mr-rooney/moitessier-hw/README.md

Hardware Design
===============

Hardware related files (gerber, schematic, etc.) of the Moitessier HAT.
