mr-rooney/moitessier-hw/PE770010E05-X1/silkscreen_bottom.png

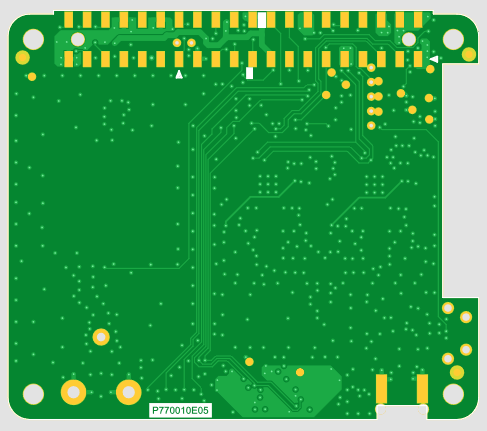
PE770010E05-X1/silkscreen_bottom.png
