mr-rooney/moitessier-hw/PE770010E05-X1/silkscreen_top.png

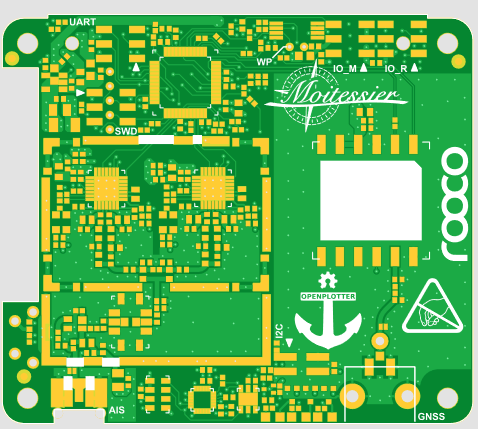
PE770010E05-X1/silkscreen_top.png
