mr-rooney/moitessier-hw/PE770010E05-X1/PE770010E05-X1-BM_v0.1.xlsx

Sheet: BOM complete
Project | Moitessier HAT
Hardware ID | P770010
Hardware Version | E05
Variant | X1
PCB Size (LxB) [mm] | 65 x 56,5
Min. Temperature Range [°C] | -20
Max. Temperature Range [°C] | 55
Manufacturer Part Number | Manufacturer | Description | Package/Case | Temperature Range [°C] |  | Reference | Quantity
GRM155R60J475ME87D | Murata | ceramic chip capacitor, 4.7uF, 6.3V, X5R, 0402 | 0402 | -55°C | 85°C | C200, C224, C606 | 3
GCM155R71C104KA55D | Murata | ceramic chip capacitor, 100n, 50V, X7R, 0402 | 0402 | -55°C | 125°C | C201, C211, C212, C213, C223, C225, C235, C236, C237, C242, C401, C402, C500, C501, C504, C601, C602, C603, C604, C605, C701, C702, C703, C704, C705, C706, C709, C711 | 28
CL10A106KP8NNNC | Samsung | ceramic chip capacitor, 10uF, 16V, X5R, 0603 | 0603 | -55°C | 85°C | C202, C226, C403, C707 | 4
C0402C120J5GACTU | Kemet | ceramic chip capacitor, 12p, 50V, C0G, 0402 | 0402 | -55°C | 125°C | C203, C208, C227, C232 | 4
CC0402DRNPO9BN100 | Yageo | ceramic chip capacitor, 10pF, 50V, NP0, 0402 | 0402 | -55°C | 125°C | C204, C206, C209, C214, C228, C230, C233, C238 | 8
C0402C102J5GACTU | Kemet | ceramic chip capacitor, 1nF, 50V, NP0, 0402 | 0402 | -55°C | 125°C | C205, C216, C217, C221, C222, C229, C241, C243, C300, C302, C303 | 11
GJM1555C1H140GB01D | Murata | ceramic chip capacitor, 14pF, 25V, NP0, 0402 | 0402 | -55°C | 125°C | C207, C218, C219, C231 | 4
885012005013 | Würth | ceramic chip capacitor, 100pF, 50V, C0G, 0402 | 0402 | -55°C | 125°C | C210, C234, C301 | 3
C0402C390J5GACTU | Kemet | ceramic chip capacitor, 39pF, 50V, NP0, 0402 | 0402 | -55°C | 125°C | C215, C239 | 2
GCM155R71H103KA55D | Murata | ceramic chip capacitor, 10nF, 50V, X7R, 0402 | 0402 | -55°C | 125°C | C220, C240, C700, C708, C710 | 5
GRM31CR60J107KE39L | Murata | ceramic chip capacitor, 100u, 6.3V, X5R, 1206 | 1206 | -55°C | 85°C | C502 | 1
CL21A106KQCLRNC | Samsung | ceramic chip capacitor, 10u, 16V, X5R, 0805 | 0805 | -55°C | 85°C | C503 | 1
885012205048 | Würth | ceramic chip capacitor, 4.7nF, 50V, X7R, 0402 | 0402 | -55°C | 125°C | C600 | 1
PESD18VF1BL | NXP | ultra low capacitance bidrectional ESD protection diode | SOD-882 | -55°C | 150°C | D300, D400 | 2
LTST-S270KGKT | Lite-On | LED, green, 45mcd |  | -30°C | 80°C | D700, D702 | 2
LTST-S270KRKT | Lite-On | LED, red, 54mcd |  | -30°C | 80°C | D701 | 1
5414373-1 | TE | BNC female jack, DC -4 GHz |  | -55°C | 85°C | J501 | 1
CRCW040212K0FKED | Vishay | thick film resistor, 12k, 1%, 100ppm, 0402, 63mW | 0402 | -55°C | 155°C | R201, R205, R601, R708, R714, R716 | 6
CRCW040251K0FKED | Panasonic | thick film resistor, 51k, 1%, 100ppm, 0402 | 0402 | -55°C | 155°C | R713 | 1
ERJ-2RKF1000X | Panasonic | thick film resistor, 100R, 1%, 100ppm, 0402 | 0402 | -55°C | 155°C | R202, R705, R706, R707, R717 | 5
RC0402FR-131KL | Yageo | thick film resistor, 1k, 1%, 100ppm, 0402 | 0402 | -55°C | 155°C | R204, R207, R504, R608, R710 | 5
CRCW08050000Z0EB | Vishay | thick film resistor, 0R, 1%, 100ppm, 0805 | 0805 | -55°C | 155°C | R300 | 1
RC0402FR-070RL | Yageo | thick film resistor, 0R, 1%, 100ppm, 0402 | 0402 | -55°C | 155°C | R302, R303, R304, R404, R606, R607 | 6
CRCW0402240RFKEDC | Vishay | thick film resistor, 240R, 1%, 100ppm, 0402 | 0402 | -55°C | 155°C | R402 | 1
CRCW04023K30FKEDC | Vishay | thick film resistor, 3.3k, 1%, 100ppm, 0402 | 0402 | -55°C | 155°C | R501, R502, R503, R600, R603, R605, R700, R715 | 8
CRCW0402100KJNEDC | Vishay | thick film resistor, 100k, 1%, 100ppm, 0402 | 0402 | -55°C | 155°C | R602 | 1
CRCW040233R0FKEDC | Vishay | thick film resistor, 33R, 1% , 100ppm, 0402 | 0402 | -55°C | 155°C | R701, R702, R703, R704 | 4
SSM3J36FS,LF | Toshiba | PMOS, -20V, -760mA | SOT-416 | -55°C | 150°C | T600 | 1
NX138BKW | NEXPERIA | N-Channel Trench MOSFET, 60V, 210 mA | SC-70-3 | -55°C | 150°C | T700, T701, T702 | 3
L86-M33 | Quectel | GPS/GNSS antenna module supporting parallel GPS/GLONASS | 18.4x18.4mm | -40°C | 85°C | U400 | 1
CAT24C32YI | Microchip | 32kBit I2C EEPROM | TSSOP-8 | -40°C | 85°C | U500 | 1
MS5607-02BA03 | Measurement Specialties | barometric pressure sensor, 10mBar to 1200mBar | QFN-8 | -40°C | 85°C | U600 | 1
MPU-9250 | InvenSense | 9-axis (gyro + accelerometer + compass) MEMS motion tracking device | QFN-24 | -40°C | 105°C | U602 | 1
STM32F091CBT6 | STMicroelectronics | ARM Cortex-M0 32 Bit MCU, 128 kB Flash, 32 kB RAM, 48 MHz | LQFP-48 | -40°C | 85°C | U700 | 1
TA0395A | Golledge | SAW filter 159.1625 MHz, max. 20 dBm continuous power input level | 7.0x5.0mm | -30°C | 70°C | FL200 | 1
61004021821 | Würth | header, 2.54mm, 20x2 pin, vertical, surface mount |  | -40°C | 105°C | J502 | 1
7427927261 | Würth | EMI suppression ferrite bead, 100mA, 0.6R, Z=600R@100MHz | 0402 | -55°C | 125°C | L200, L209, L210, L219 | 4
744761215A | Würth | ceramic chip inductor, 0603, 150 nH, 280 mA, 0.92 RDC | 0603 | -40°C | 125°C | L201, L207, L211, L217 | 4
744761168C | Würth | ceramic chip inductor, 0603, 68nH, 600mA, 0.35RDC | 0603 | -40°C | 125°C | L202, L203, L206, L212, L213, L216 | 6
744761172GA | Würth | wire wound ceramic inductor, 0603, 72nH, 2%, 400mA, 0.49RDC, Q=35@150MHz | 0603 | -40°C | 125°C | L208, L218 | 2
744761212C | Würth | wire wound ceramic inductor, 0603, 120nH, 300mA, 0.65RDC, Q=30@150MHz | 0603 | -40°C | 125°C | L204, L205, L214, L215 | 4
744761210A | Würth | ceramic chip inductor, 0603, 100 nH, 400 mA, 0.63 RDC | 0603 | -40°C | 125°C | L300 | 1
742792641 | Würth | EMI suppression ferrite bead, 2A, 0.15R, Z=300R@100MHz | 0603 | -55°C | 125°C | L500 | 1
82357050100 | Würth | ESD suppressor, 5VDC, 60Vclamp, 10pF | 0402 | -40°C | 85°C | D706 | 1
431256038736 | Würth | tactile switch, THT, right angle, 6x6mm |  | -40°C | 85°C | SW700 | 1
S0981-46R | Harwin | clips for S02-30200250 |  |  |  | (see note A) | 4
62100621921 | Würth | header, 2mm, 2x3pin, vertical |  | -40°C | 125°C | J701 | 1
ASF143 | ASB | RF amplifier, 22.7dB | SOT-343 | -65°C | 150°C | U300 | 1
AX5043 | AXSEM | advanced high performance ASK and FSK narrow-band transceiver for 27-1050MHz range | QFN-28 | -40°C | 85°C | U200, U201 | 2
DSB221SDN-13.0000-3.3V-0.5-CS-E | DAISHINKU CORP. | TCXO, 13MHz, -40°C - 85°C, clipped sinde, +/- 0.5ppm frequency stability | 2.5x2.0mm | -40°C | 85°C | X200, X201 | 2
SMA-J-P-H-ST-EM1 | Samtec | SMA socket (female), DC - 6 GHz, edge mount |  | -65°C | 125°C | J500 | 1
Parts available on the assembly diagram and specified in the pick and place file, but not assembled:
Manufacturer Part Number | Manufacturer | Description | Package/Case | Temperature Range [°C] |  | Reference | Quantity
S02-30200250 | Harwin | shielding cabinet, 30x20x3, 4x S1721-46R or 4x S0981-46R clips required (depending on footprint)!!! | 30x20x3mm |  |  | SH200 (see note A) (do not order and do not assemble) | 1
Note A:
The HARWIN shield (SH200) requires 4 clips on the PCB. There are no references for the clips and there is no position data in the pick and place file. Therefore it is necessary to add position information for the assembly machine manually.

Sheet: Selection
ja | -40/85
nein | -55/150
 | -40/125
 | -55/155
 | -55/125
 | 0/70
