mr-rooney/moitessier-hw/PE770010E05-X1/PDF/P770010E05-X1-SH-x.pdf

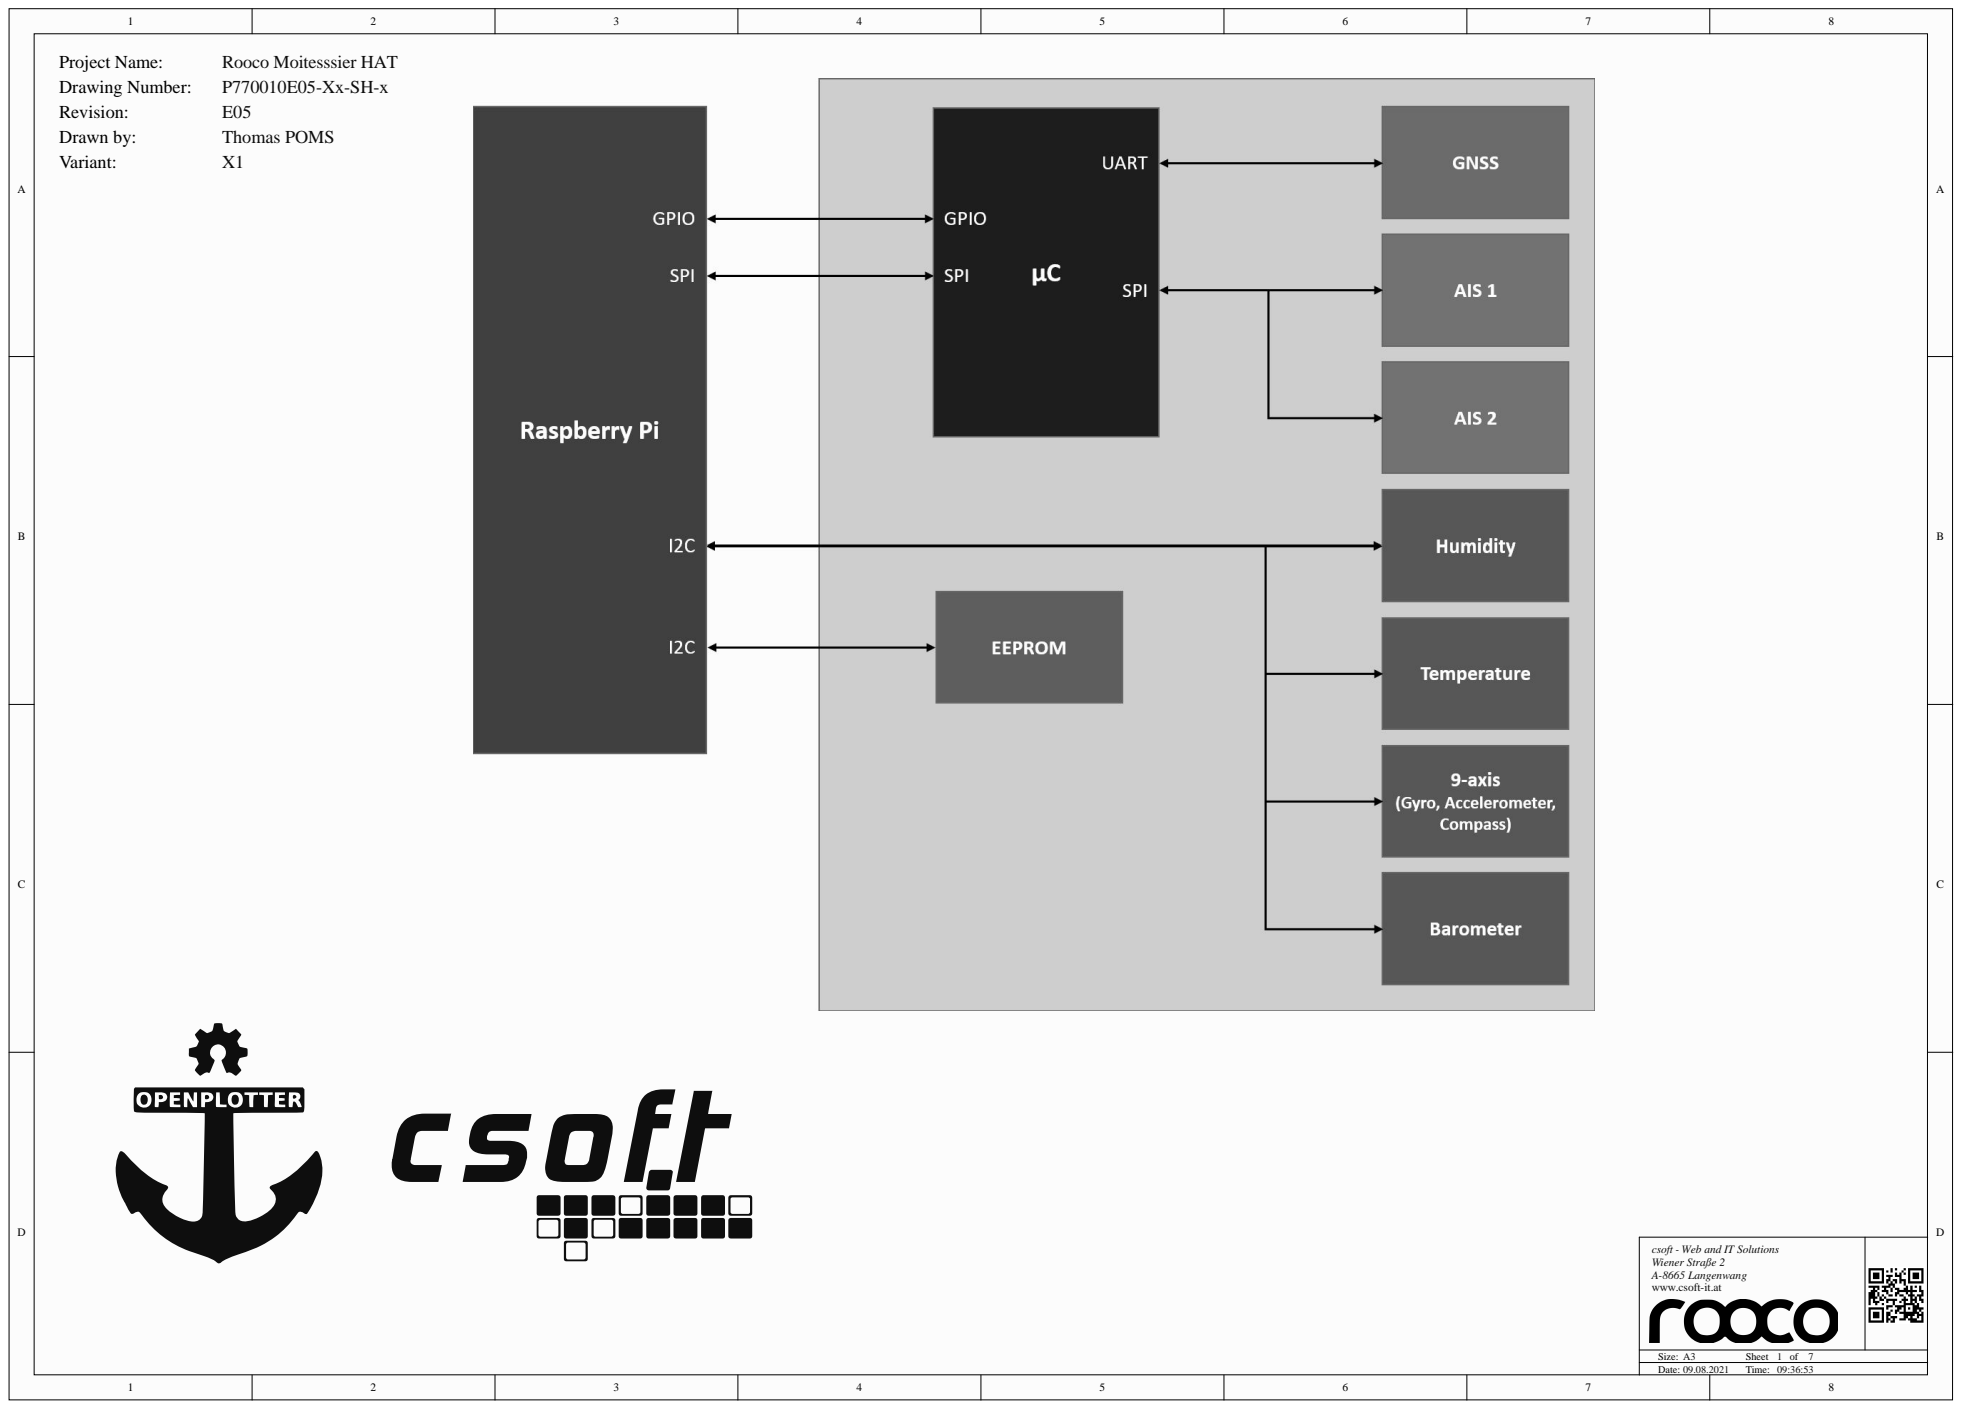
[picture p3: page 1]

csoft - Web and IT Solutions
Wiener Straße 2
A-8665 Langenwang
www.csoft-it.at

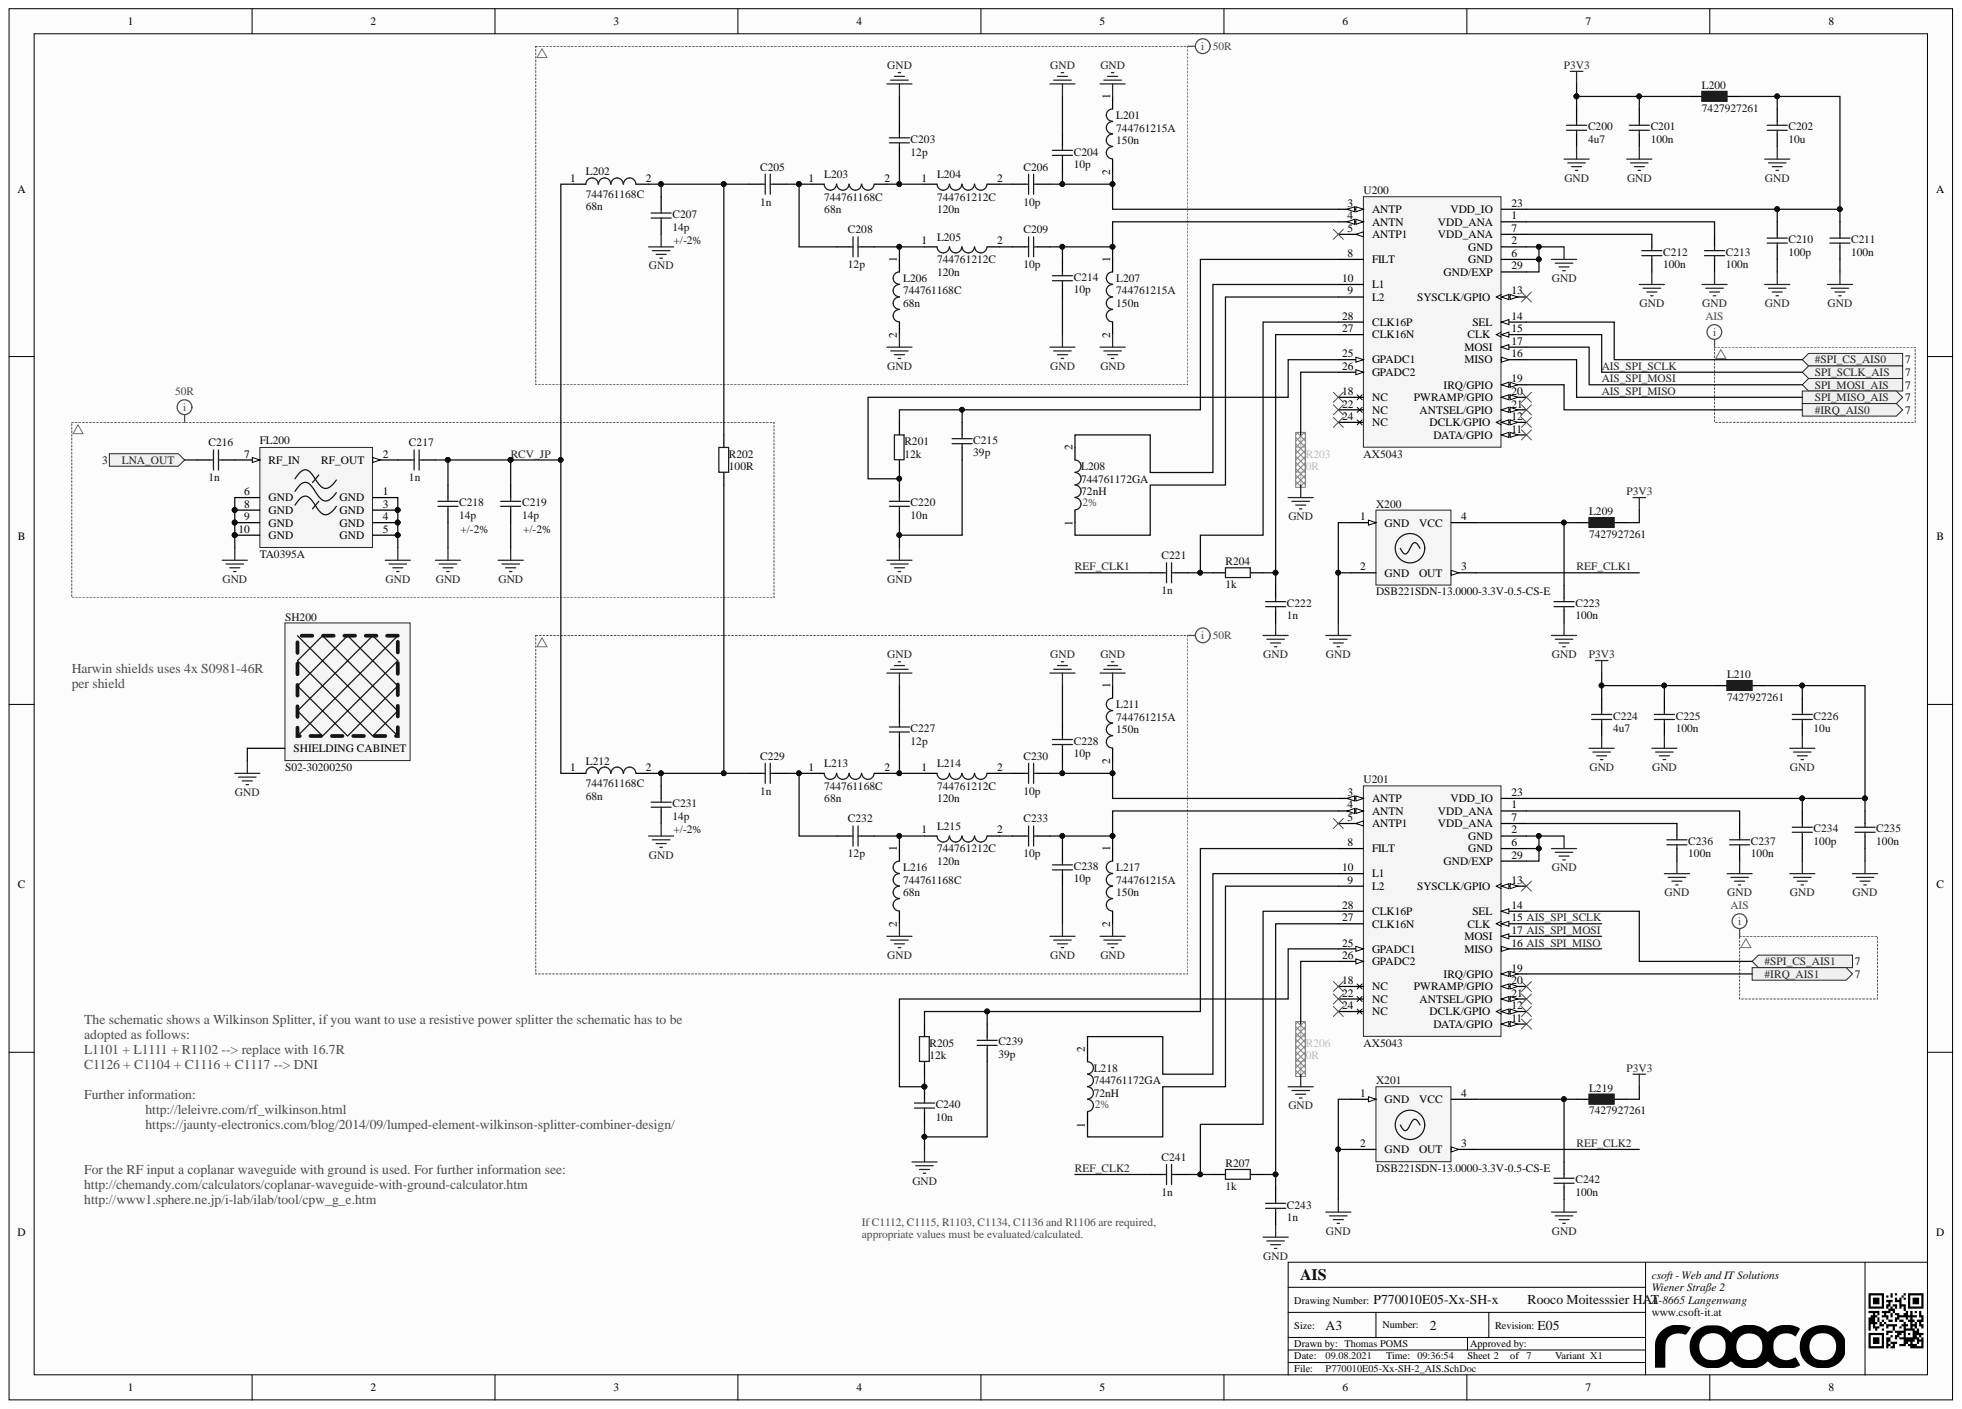
[picture p4: page 2]

The schematic shows a Wilkinson Splitter, if you want to use a resistive power splitter the schematic has to be
adopted as follows:
L1101 + L1111 + R1102 --> replace with 16.7R
C1126 + C1104 + C1116 + C1117 --> DNI

http://leleivre.com/rf_wilkinson.html
https://jaunty-electronics.com/blog/2014/09/lumped-element-wilkinson-splitter-combiner-design/

For the RF input a coplanar waveguide with ground is used. For further information see:
http://chemandy.com/calculators/coplanar-waveguide-with-ground-calculator.htm
http://www1.sphere.ne.jp/i-lab/ilab/tool/cpw_g_e.htm

If C1112, C1115, R1103, C1134, C1136 and R1106 are required,
appropriate values must be evaluated/calculated.

csoft - Web and IT Solutions
Wiener Straße 2
A-8665 Langenwang
www.csoft-it.at

Size: | 2 Number: | E05

Drawn by: Thomas POMS | Approved by:

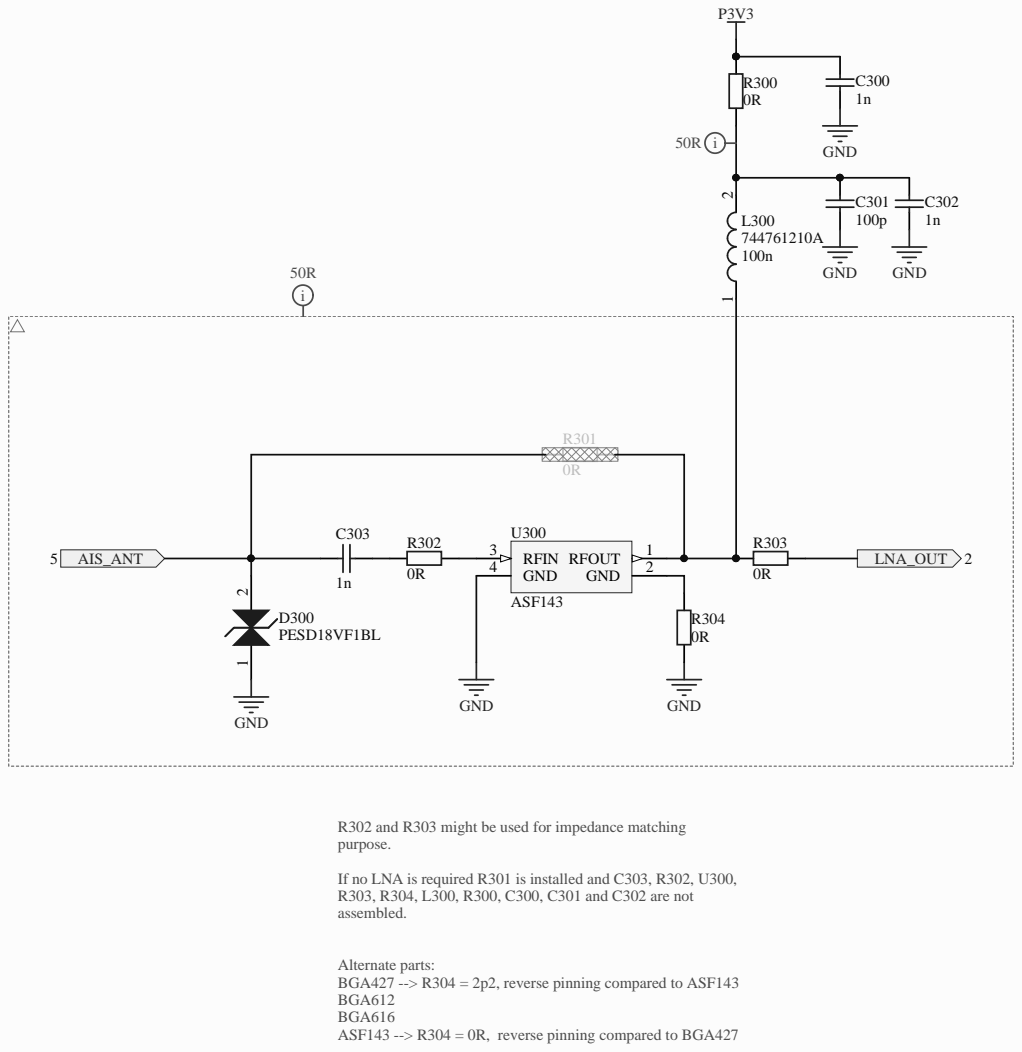
[picture p5: page 3]

R302 and R303 might be used for impedance matching
purpose.

If no LNA is required R301 is installed and C303, R302, U300,
R303, R304, L300, R300, C300, C301 and C302 are not
assembled.

Alternate parts:
BGA427 --> R304 = 2p2, reverse pinning compared to ASF143
BGA612
BGA616
ASF143 --> R304 = 0R, reverse pinning compared to BGA427

csoft - Web and IT Solutions
Wiener Straße 2

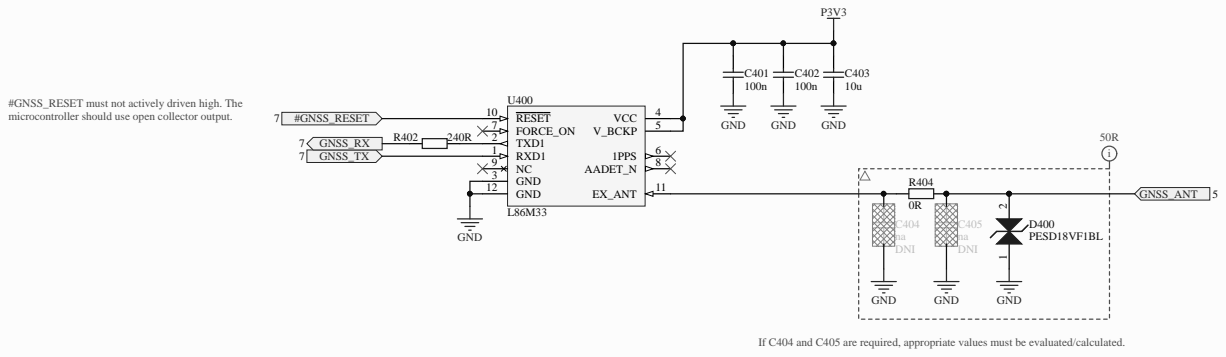
[picture p6: page 4]

#GNSS_RESE
microcontroller should use open collector output.

T must not actively driven high.

If C404 and C405 are required, appropriate values must be evaluated/calculated.

csoft - Web and IT Solutions Wiener Straße 2 A-8665 Langenwang

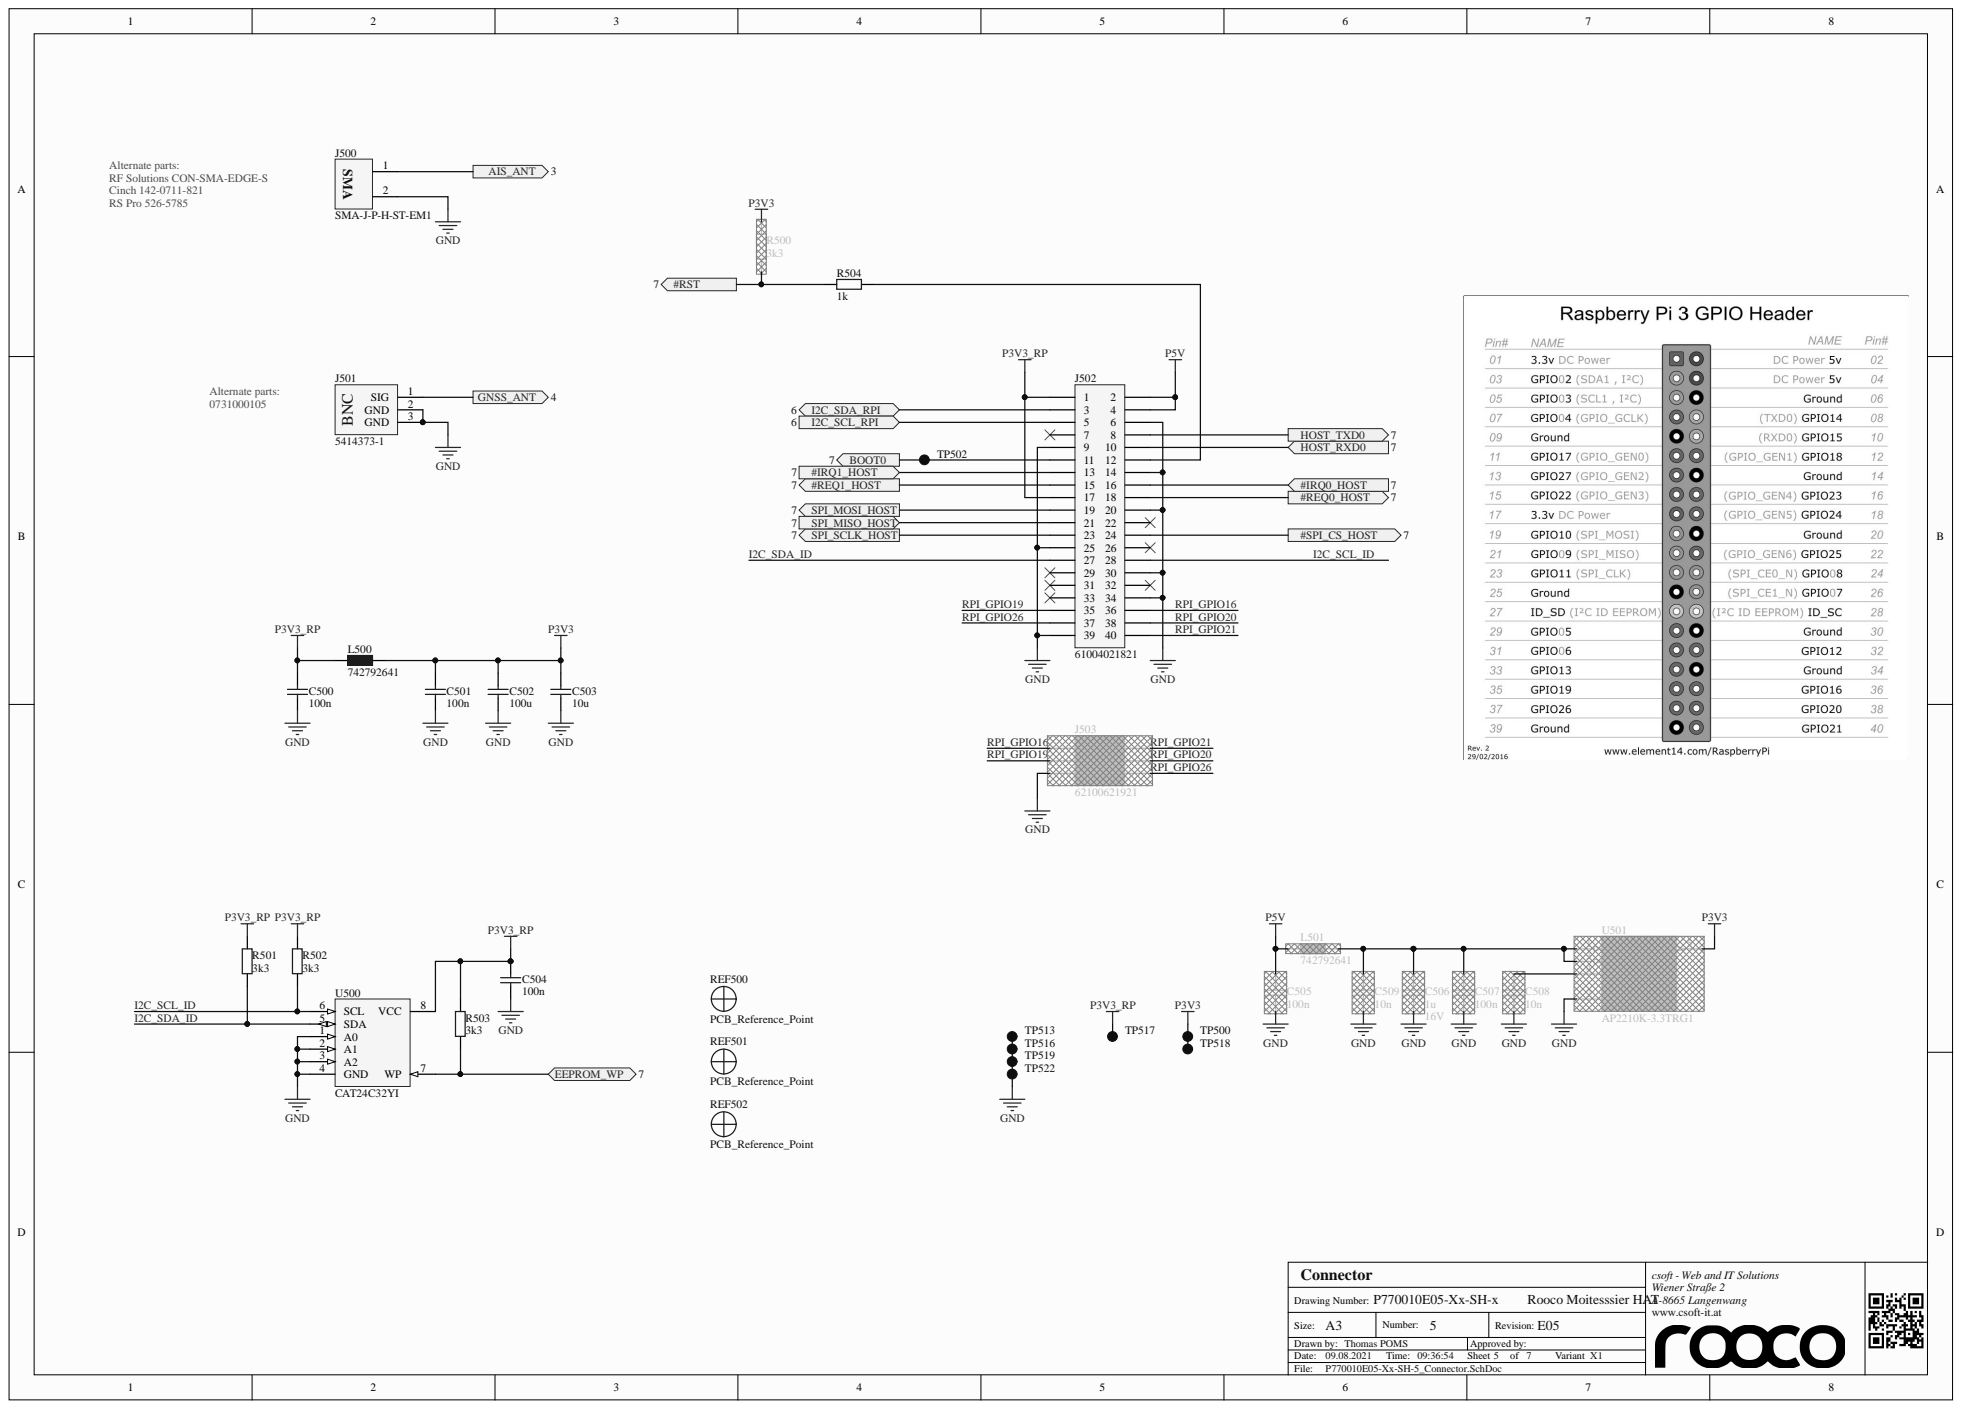
[picture p7: page 5]

Alternate parts:
RF Solutions CON-SMA-EDGE-S
Cinch 142-0711-821
RS Pro 526-5785

GND 2

A1 2
A2 3
GND 4

csoft - Web and IT Solutions
Wiener Straße 2

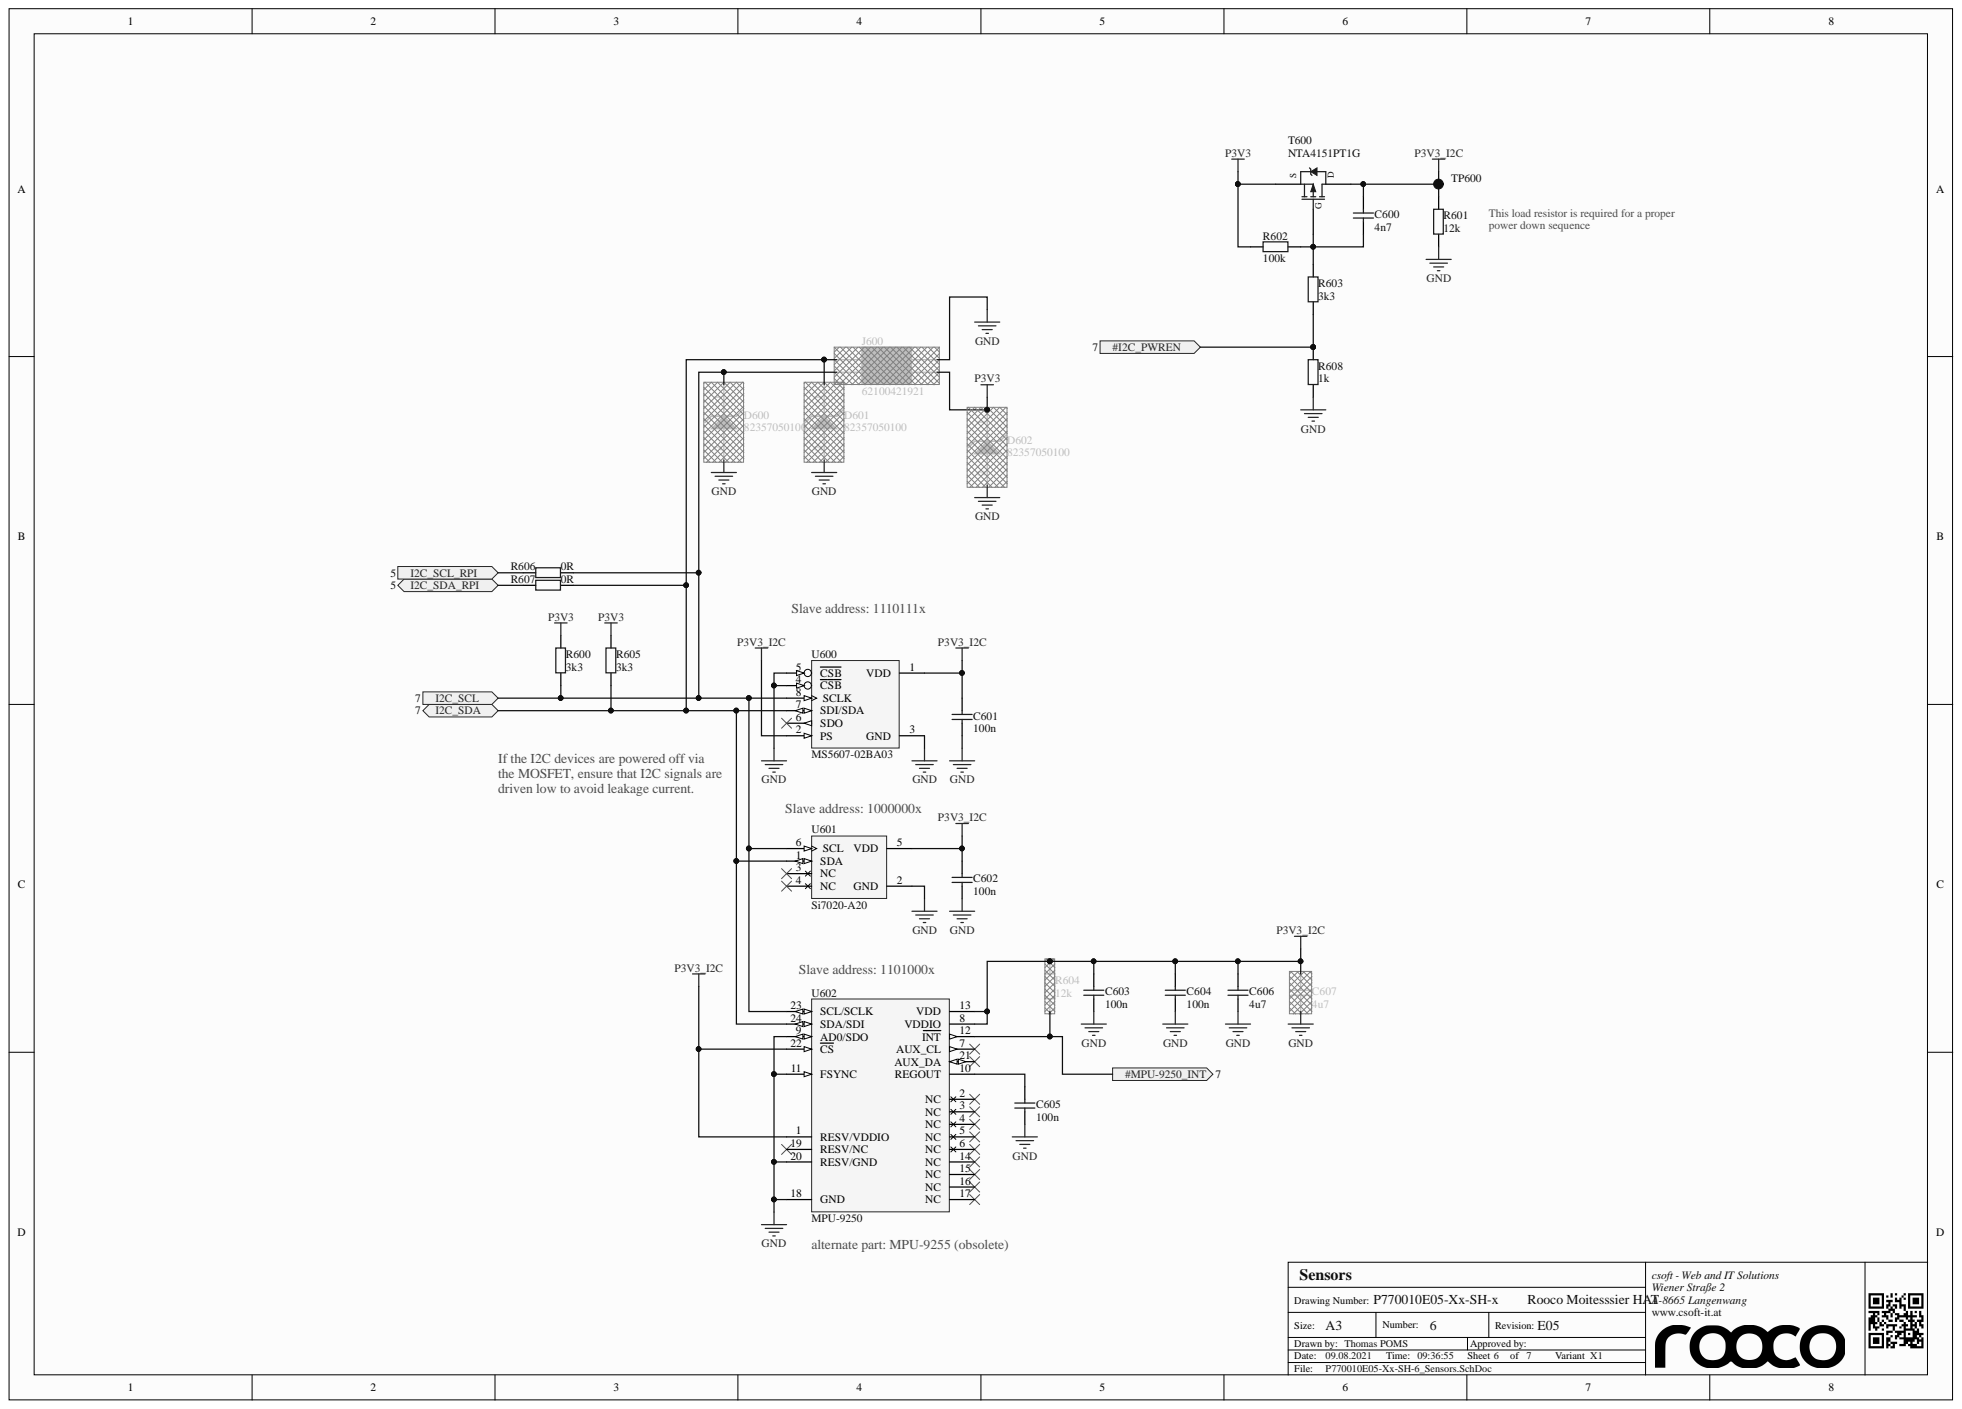
[picture p8: page 6]

This load resistor is required for a proper
power down sequence

If the I2C devices are powered off via
the MOSFET, ensure that I2C signals are
driven low to avoid leakage current.

RESV/VDDIO 1
RESV/NC 19

alternate part: MPU-9255 (obsolete)

csoft - Web and IT Solutions
Wiener Straße 2

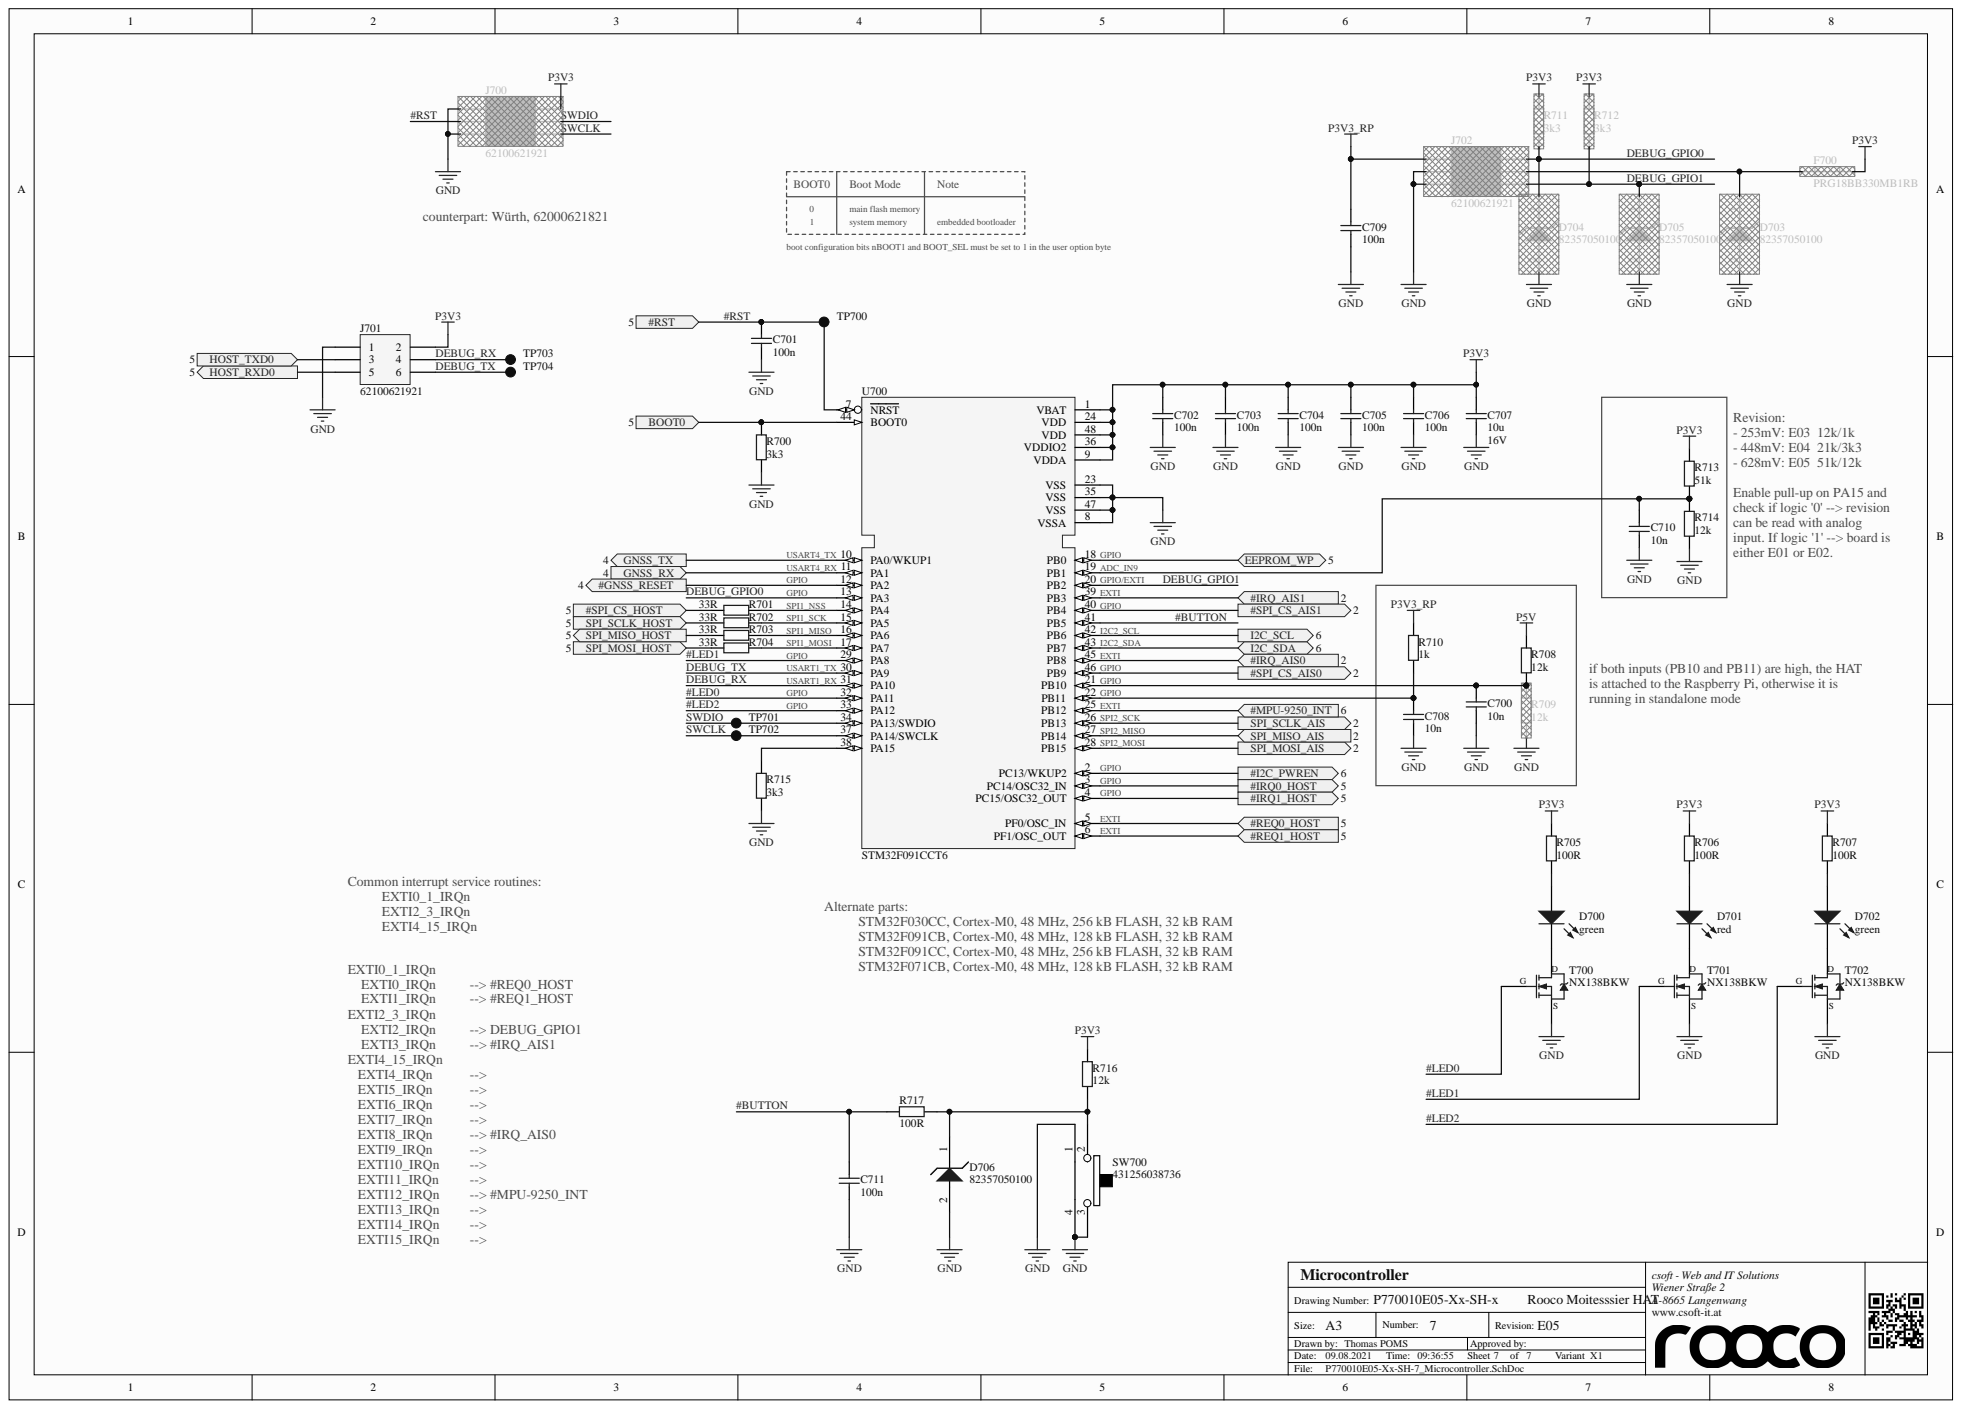
[picture p9: page 7]

0 1 | main flash memory system memory | embedded bootloader

boot configuration bits nBOOT1 and BOOT_SEL must be set to 1 in the user option byte

Enable pull-up on PA15 and
check if logic '0' --> revision
can be read with analog
input. If logic '1' --> board is

if both inputs (PB10 and PB11) are high, the HAT
is attached to the Raspberry Pi, otherwise it is
running in standalone mode

GPIO

Alternate parts:
STM32F030CC, Cortex-M0, 48 MHz, 256 kB FLASH, 32 kB RAM
STM32F091CB, Cortex-M0, 48 MHz, 128 kB FLASH, 32 kB RAM
STM32F091CC, Cortex-M0, 48 MHz, 256 kB FLASH, 32 kB RAM
STM32F071CB, Cortex-M0, 48 MHz, 128 kB FLASH, 32 kB RAM

csoft - Web and IT Solutions
Wiener Straße 2
