mr-rooney/moitessier-hw/PE770010E05-X1/PDF/P770010E05-X1-AD-x.pdf

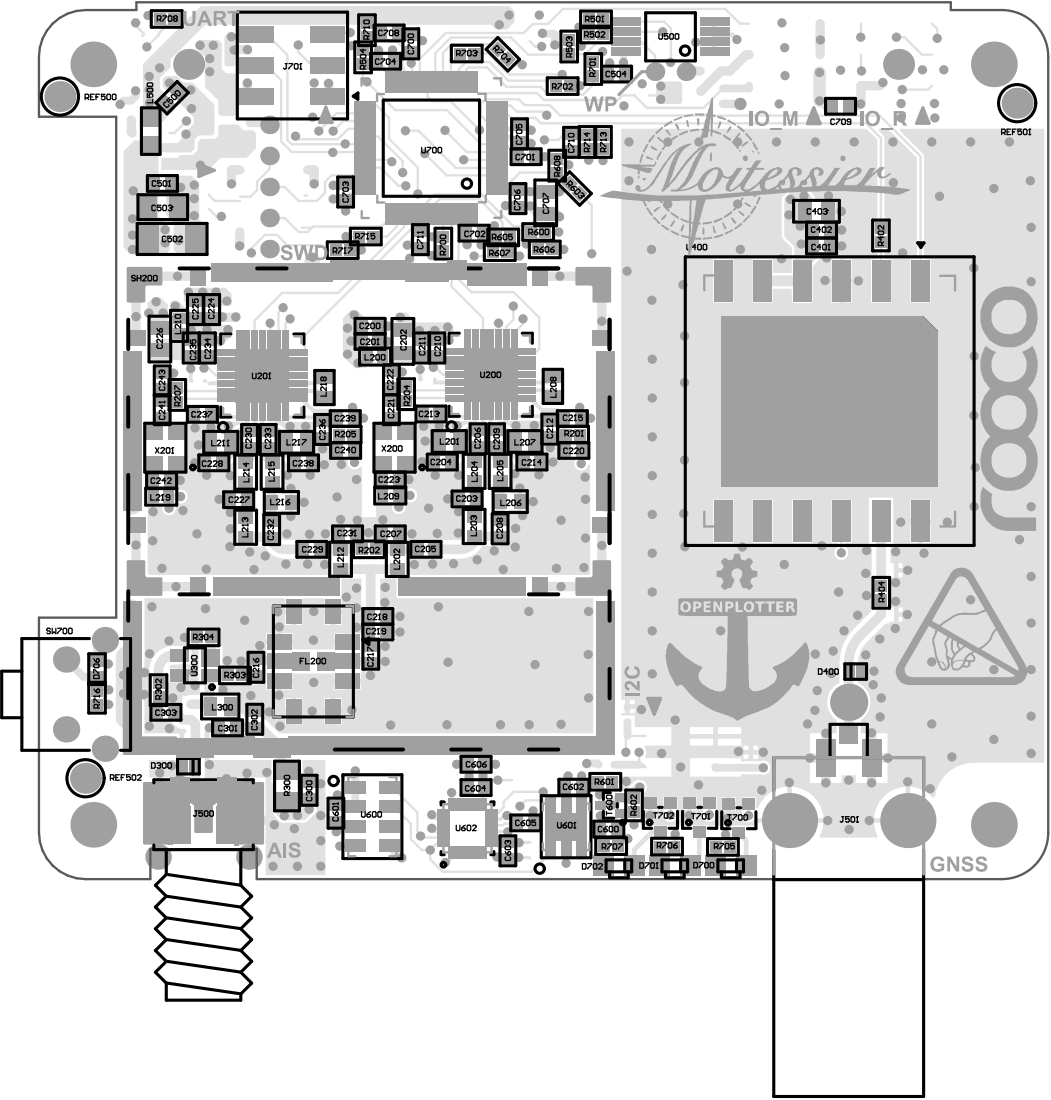
[picture p10: page 1]

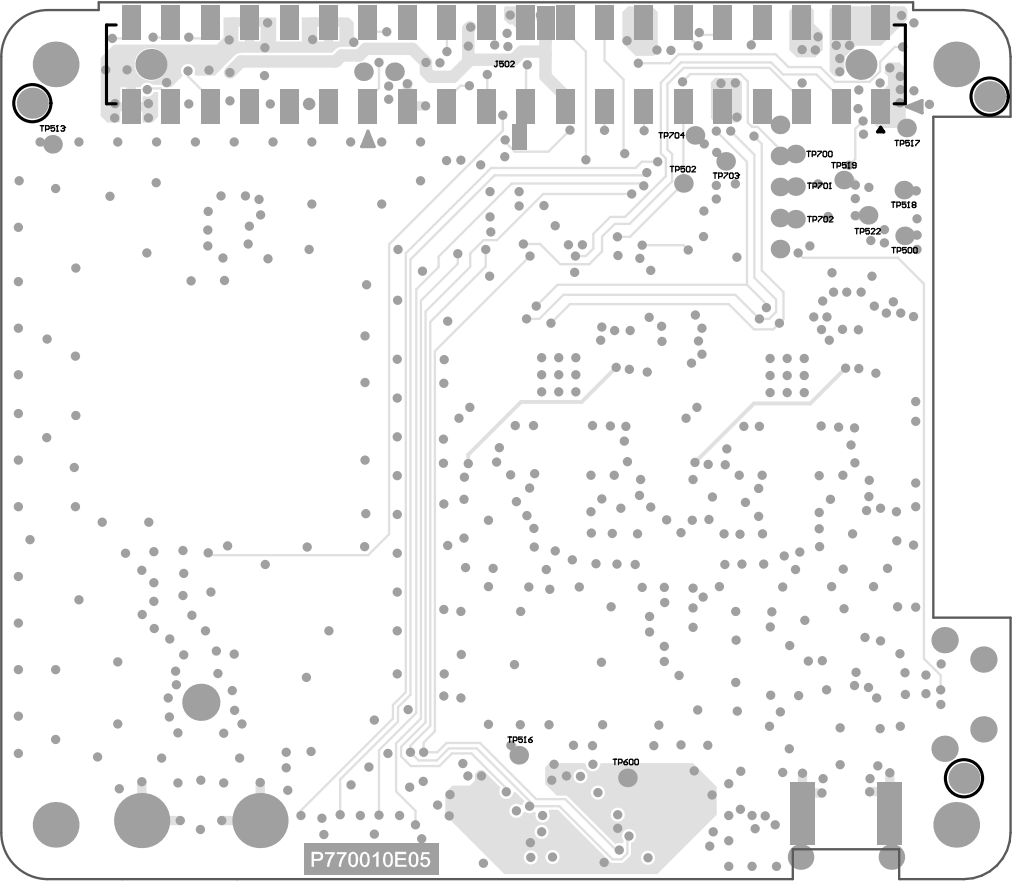
[picture p11: page 2]
