mr-rooney/moitessier-hw/PE770010E05-X1/PDF/P770010E05-X1-LY-x.pdf

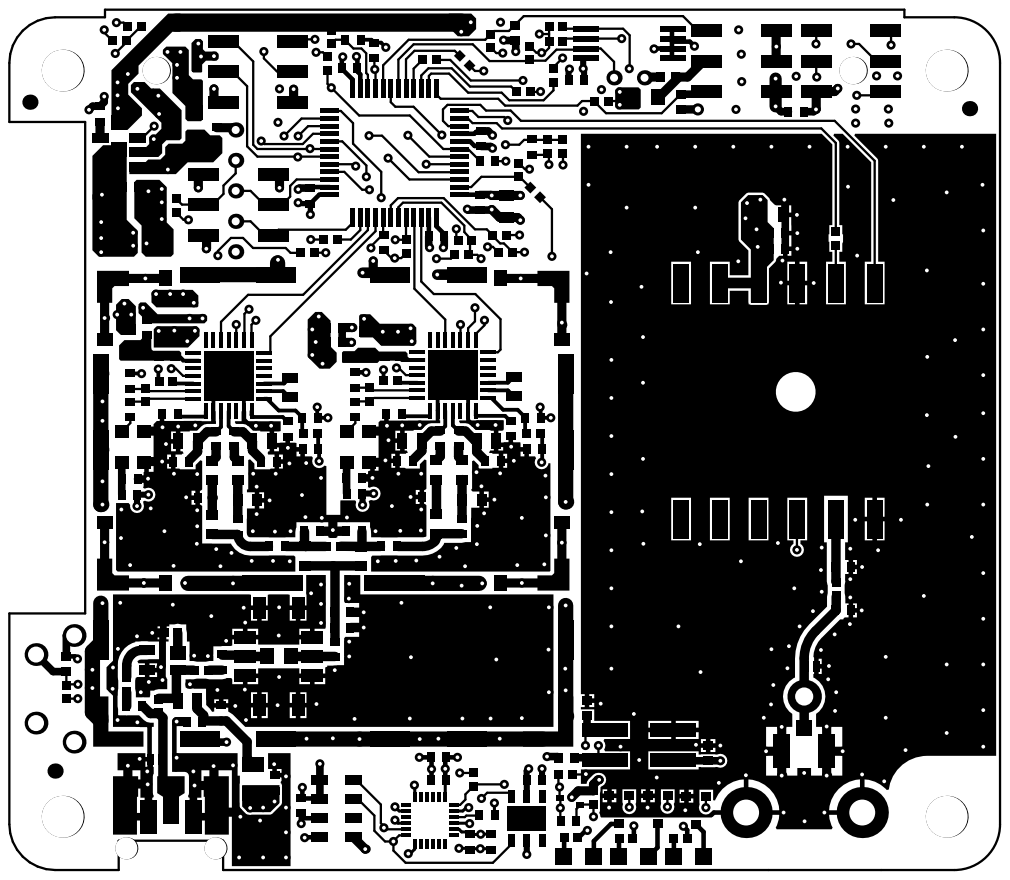
[picture p12: page 1]

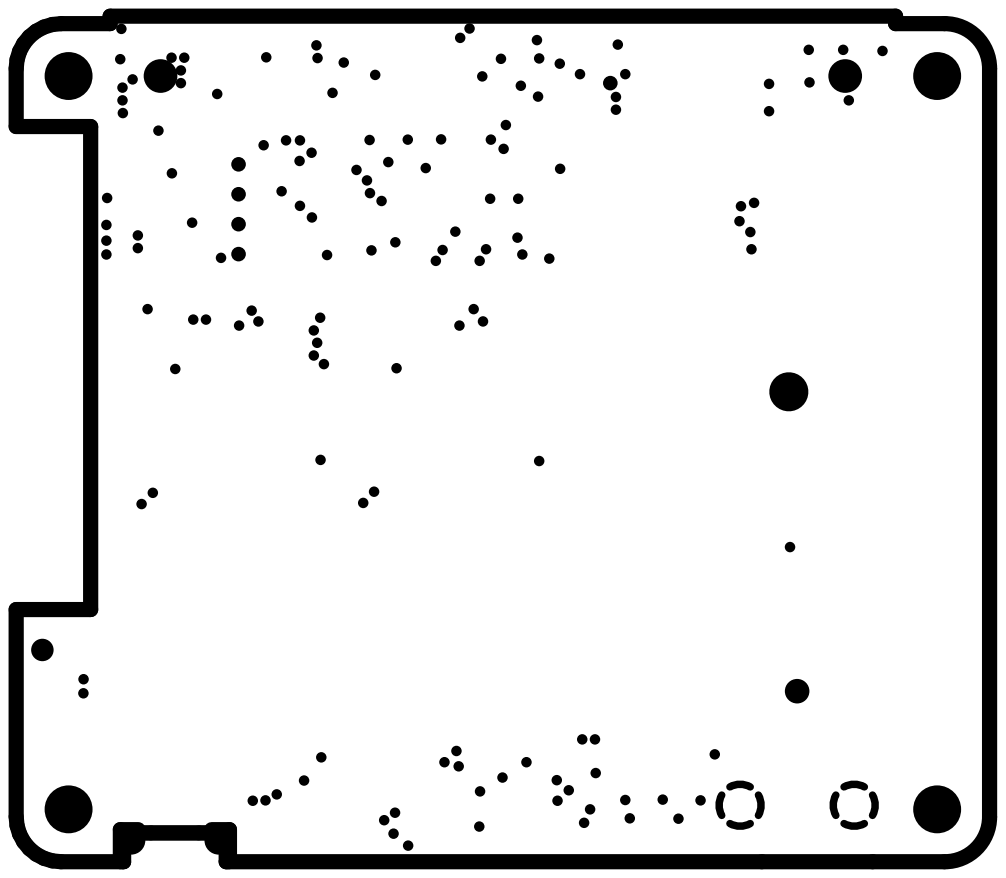
[picture p13: page 2]

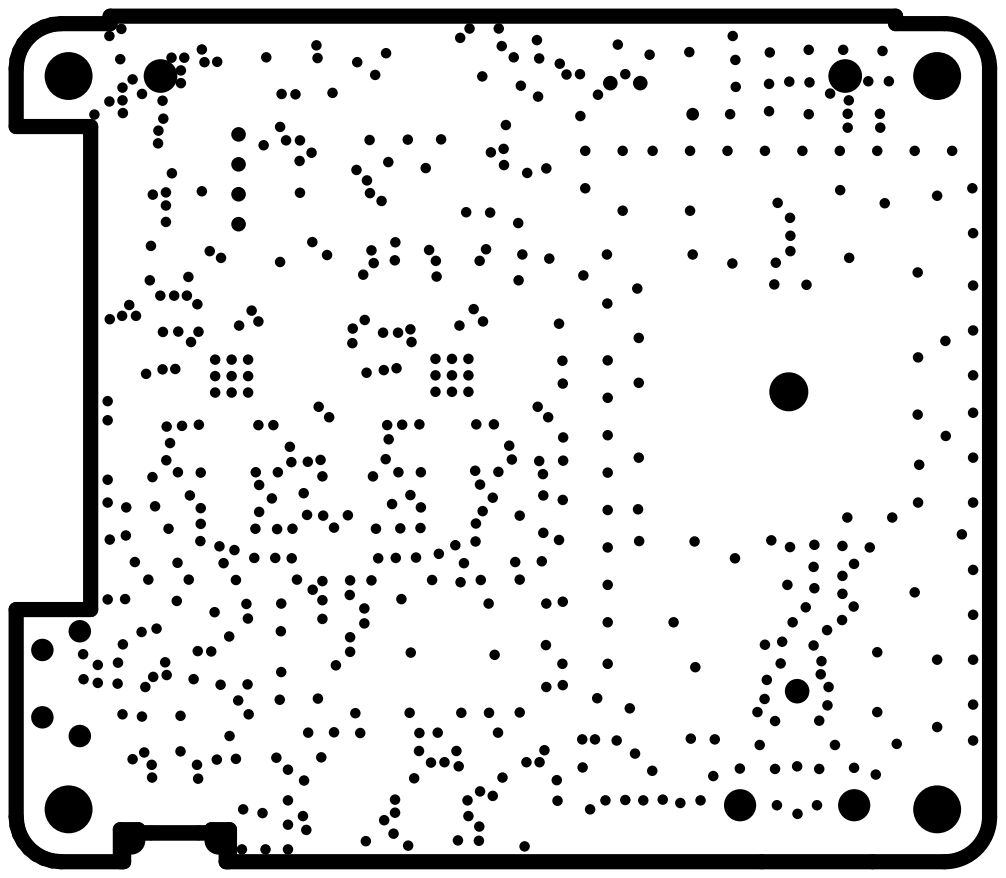
[picture p14: page 3]

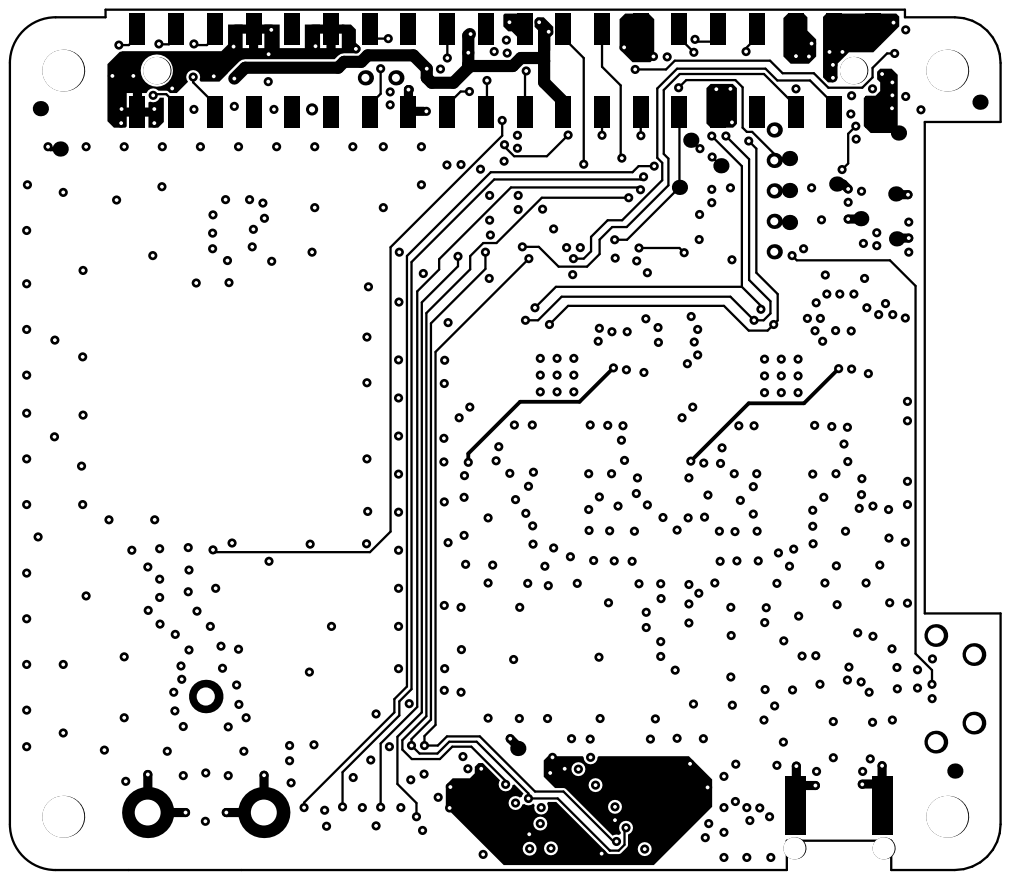
[picture p15: page 4]
