mr-rooney/moitessier-hw/PE770010E05-X1/PDF/P770010E05-X1-MD-x.pdf

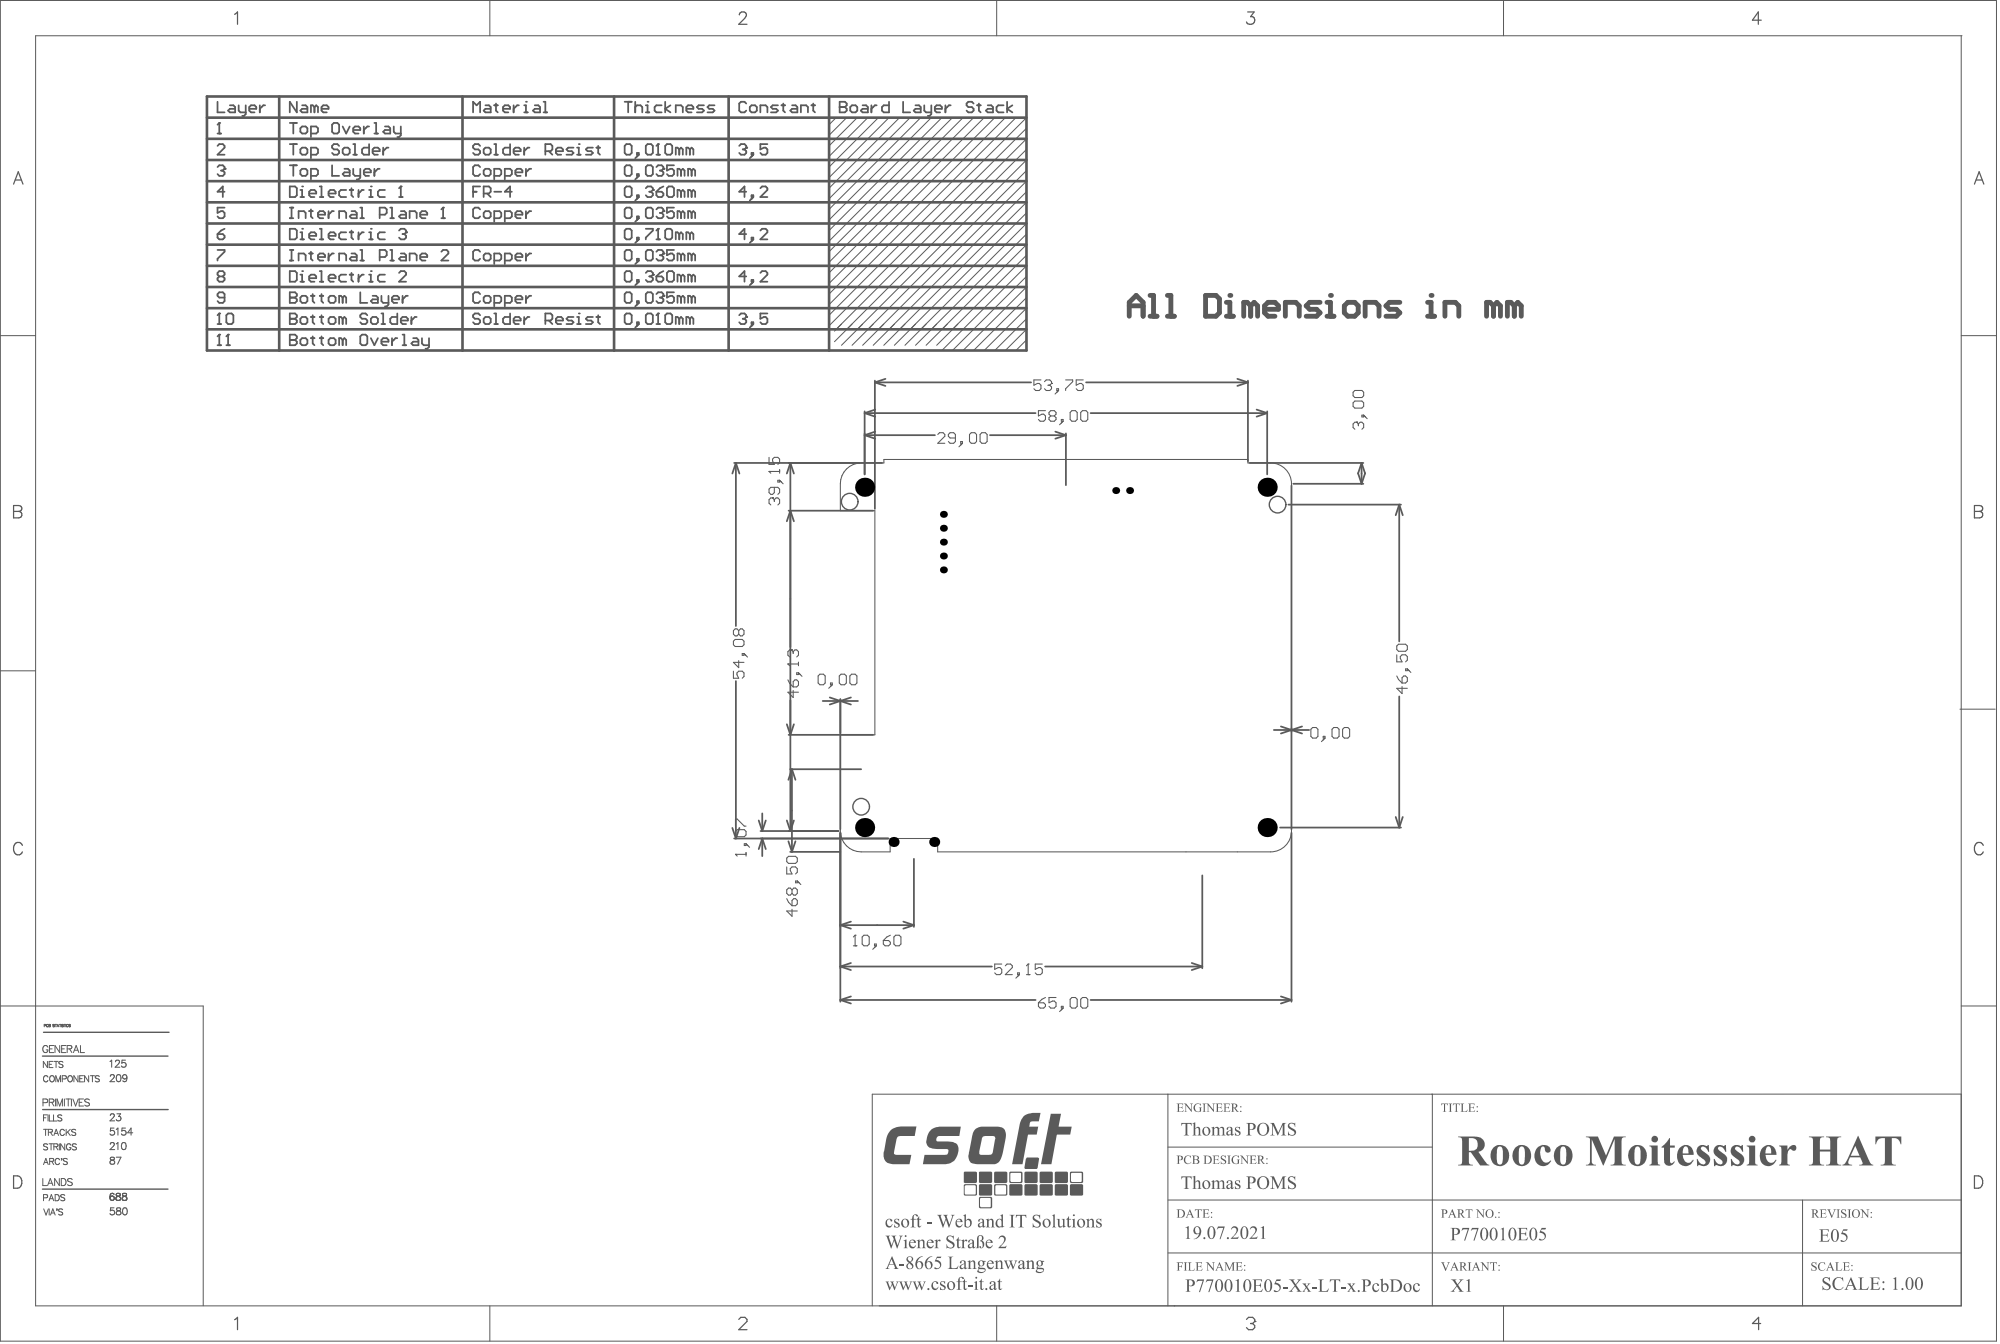
[picture p16: page 1]
