mr-rooney/moitessier-hw/(commit log)

2021-07-20 * Initial commit.
    [PE770010E05-X1-BM_v0.1.xlsx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]
2021-08-09 * Schematic updated. Net labels for power supply symbols were missing.
